spherical-sound-society/airtouch/programming IDE.jpg

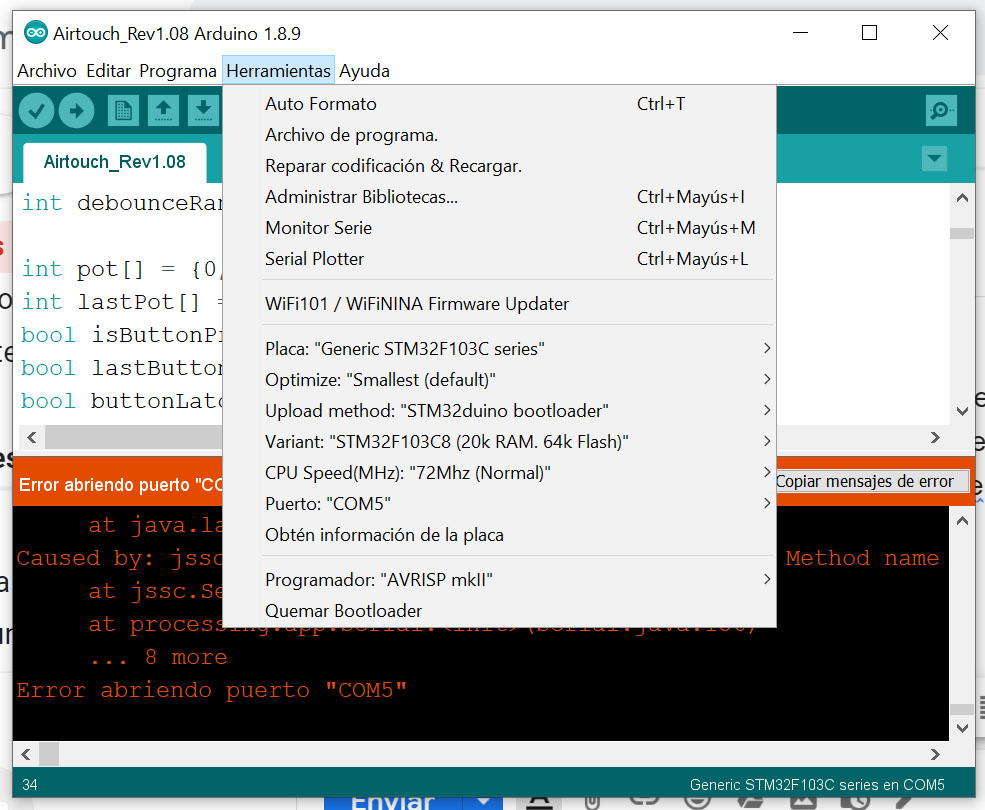
programming IDE.jpg
