spherical-sound-society/airtouch/schematic.pdf

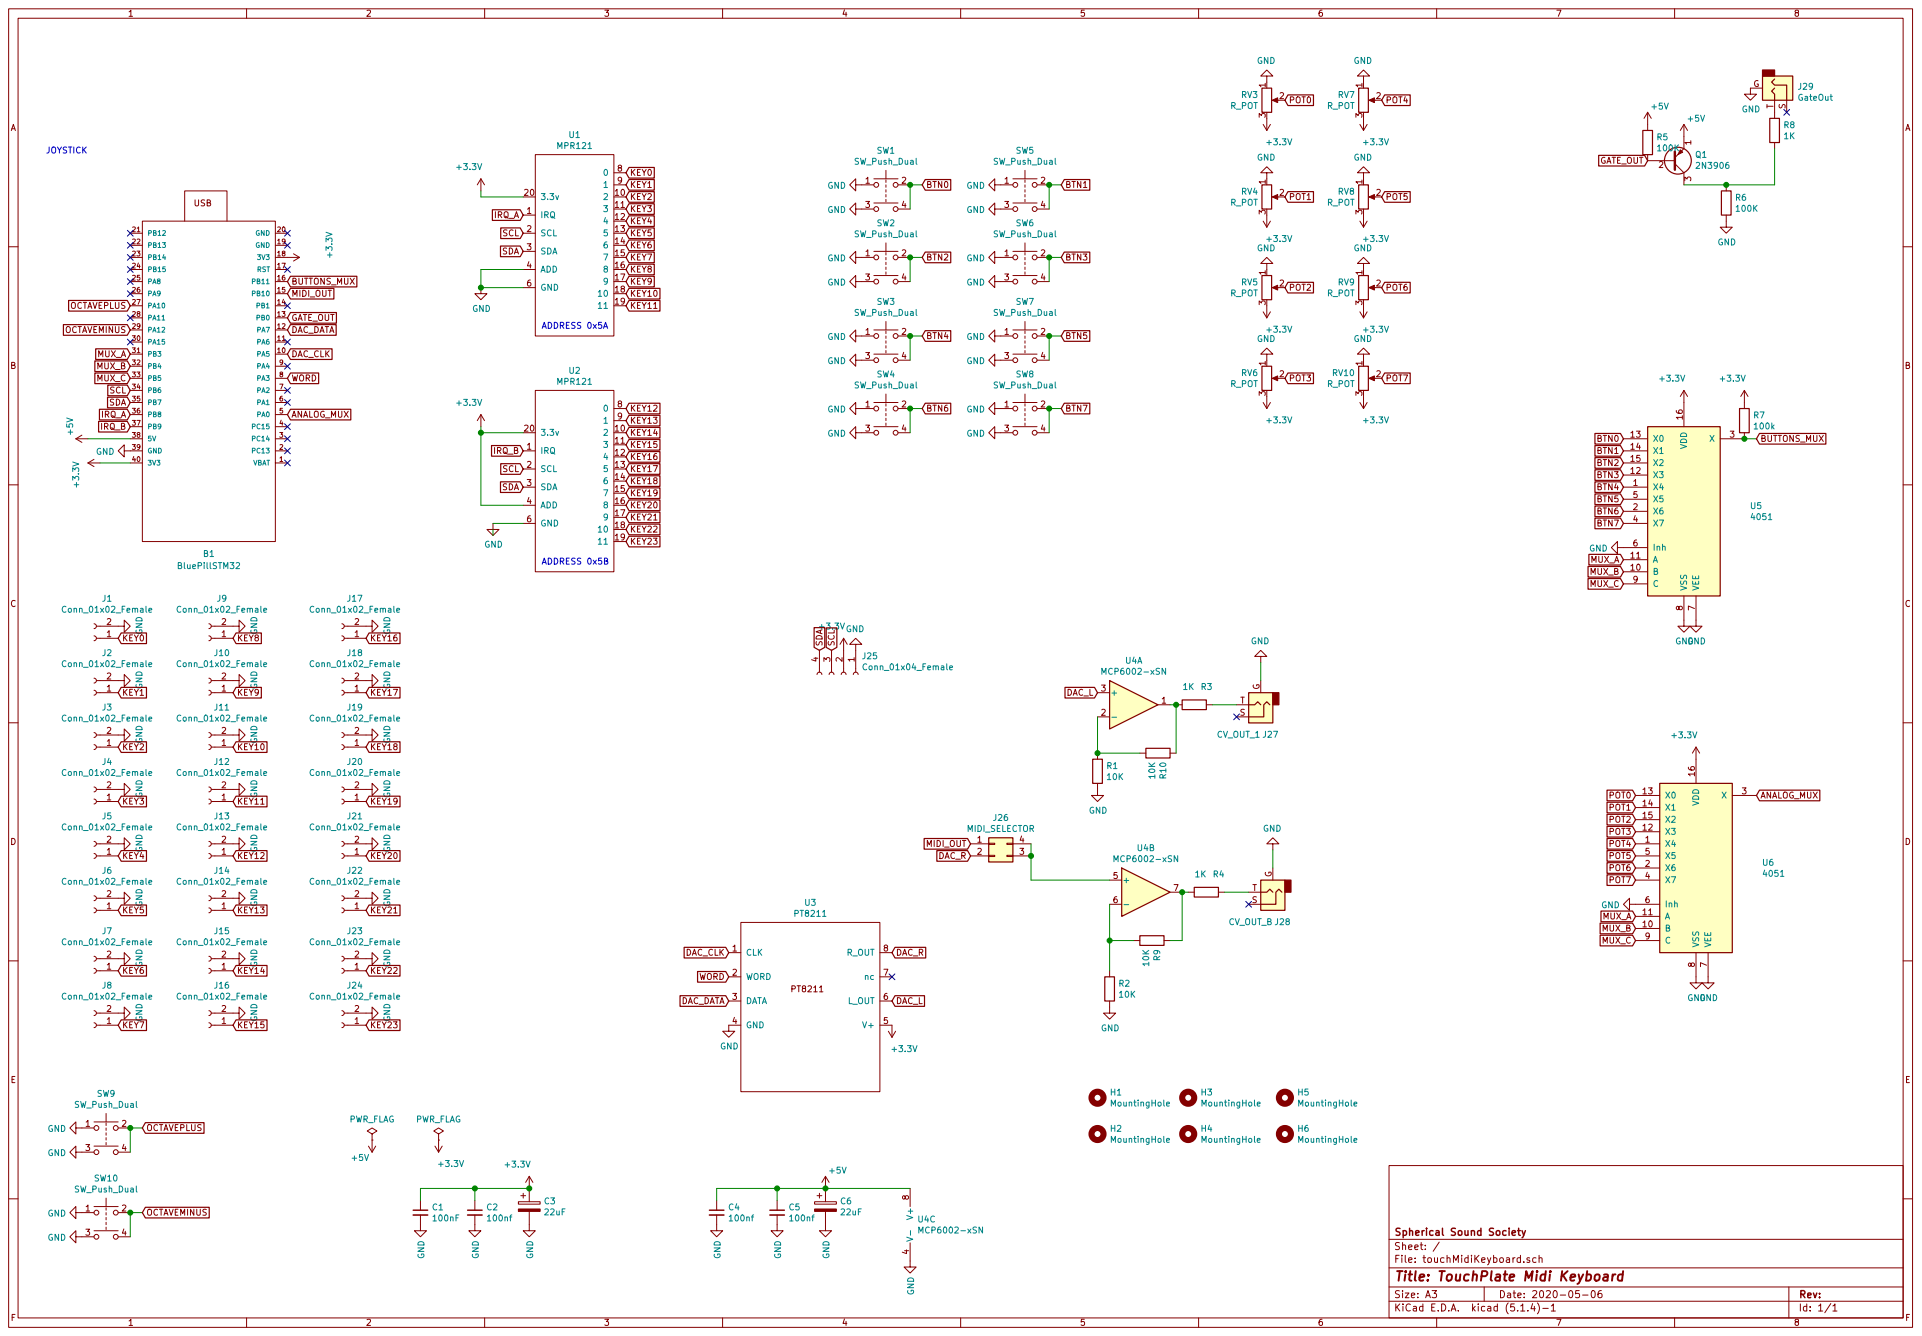
[picture p2: page 1]

File: touchMidiKeyboard.sch Sheet: / Spherical Sound Society C2

Id: 1/1 Title: TouchPlate Midi Keyboard
