spherical-sound-society/airtouch/rev0.95_fixes/REV0.95_BRIDGES.JPG

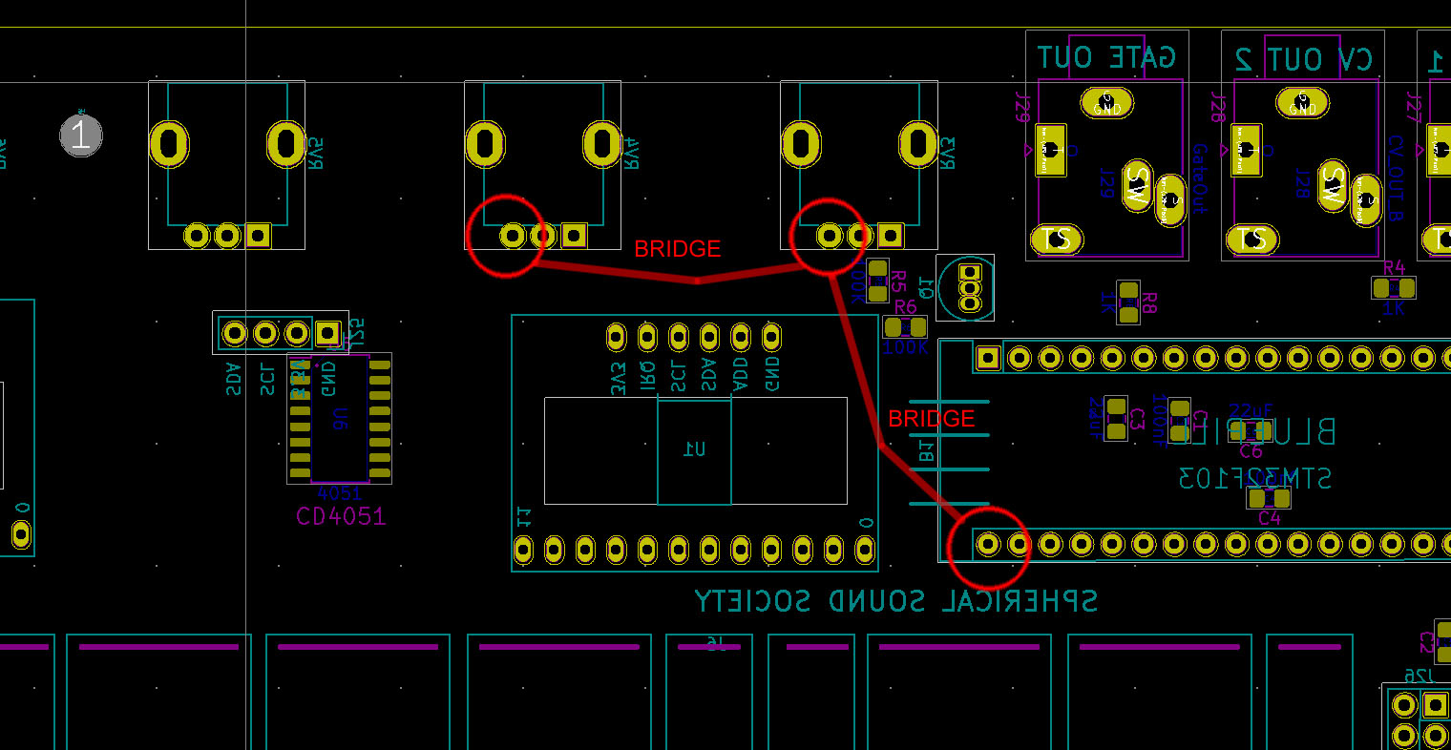
rev0.95_fixes/REV0.95_BRIDGES.JPG
