spherical-sound-society/airtouch/rev0.95_fixes/REV0.95_CUT TRACKS.JPG

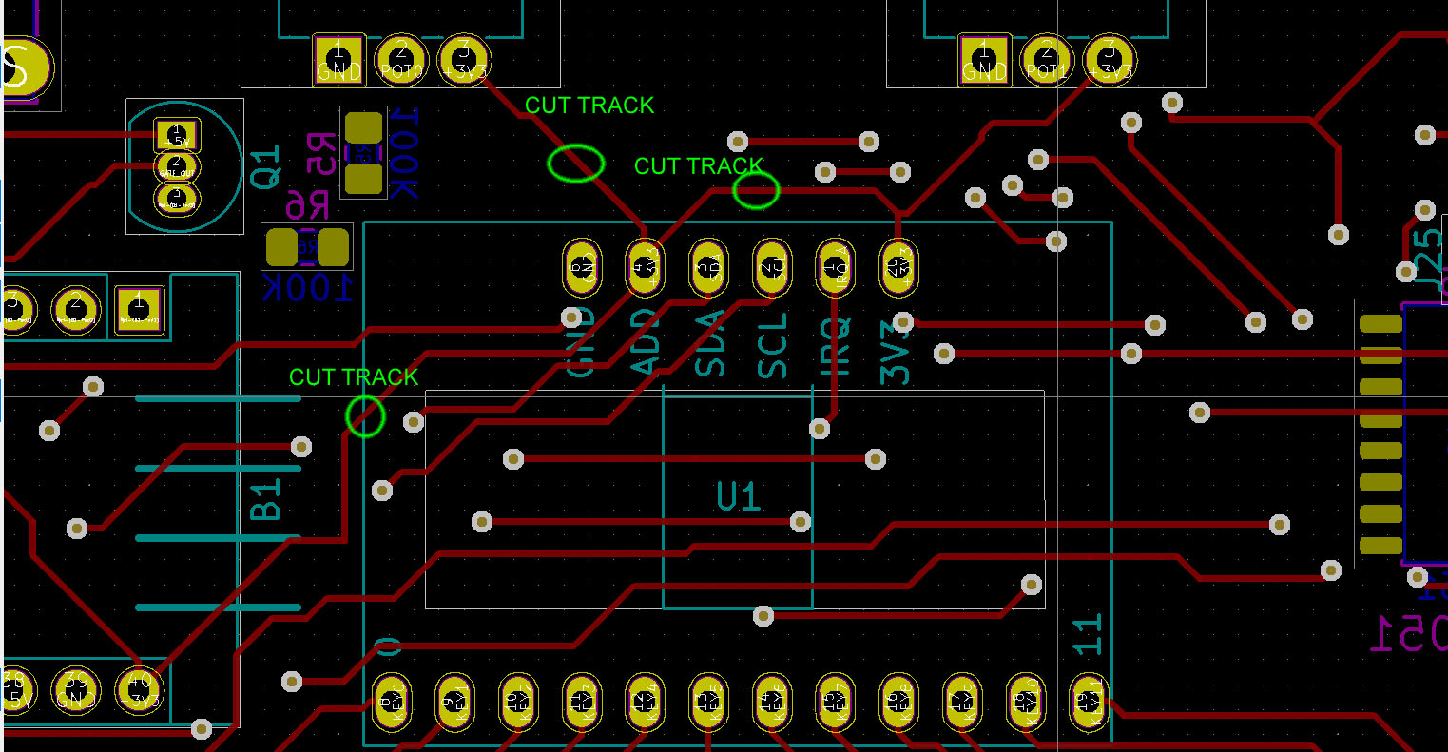
rev0.95_fixes/REV0.95_CUT TRACKS.JPG
